aljazblatnik/RF-source-6GHz/gerber/README.md

# PCB stack (beta)

The attached gerber files are a BETA version of the PCBs, as they have not yet been fully verified. The table below dictates the bord stack for PCB:
| PCB | Material | thickness | 
| --- | --- | --- |
| RF board | FR4 | 2-layer 0.6 mm |
| MCU | FR4 | 2-layer 1.6 mm |
| Buttons | FR4 | 2-layser 1.6 mm |
