aljazblatnik/RF-source-6GHz/photo/+5V supply.JPEG

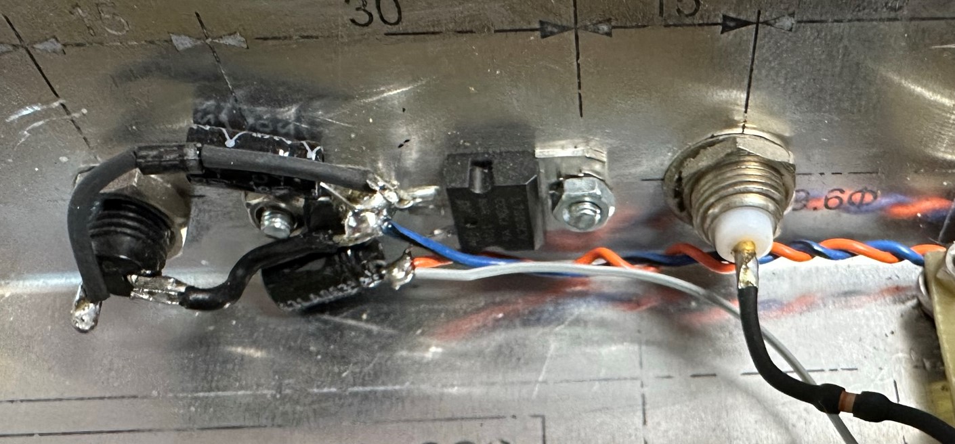
photo/+5V supply.JPEG
