aljazblatnik/RF-source-6GHz/photo/back.JPEG

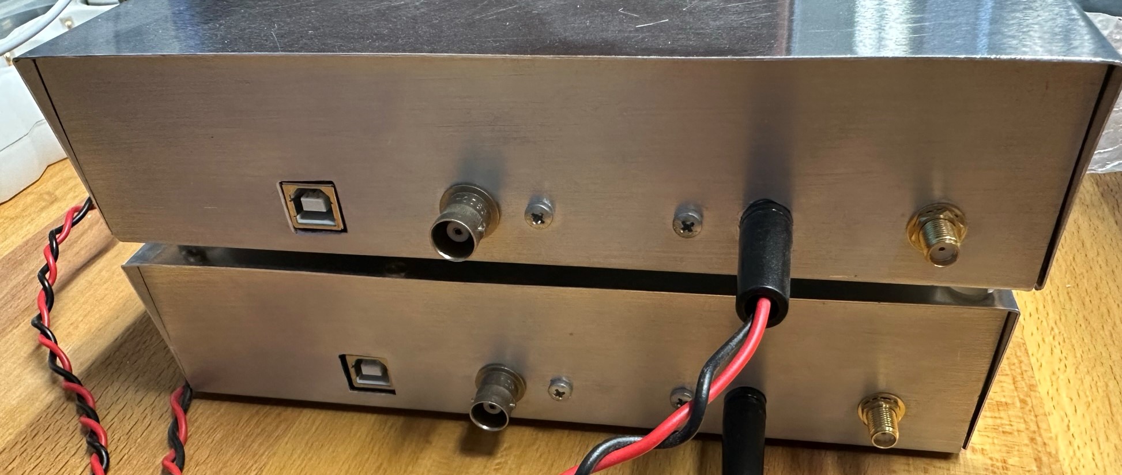
photo/back.JPEG
