aljazblatnik/RF-source-6GHz/photo/buttons.JPEG

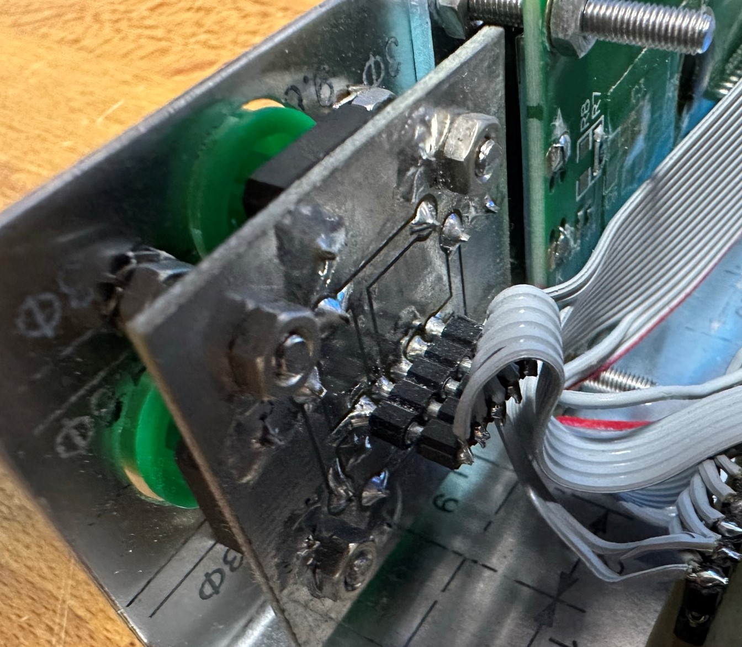
photo/buttons.JPEG
