aljazblatnik/RF-source-6GHz/photo/buttons_back.jpg

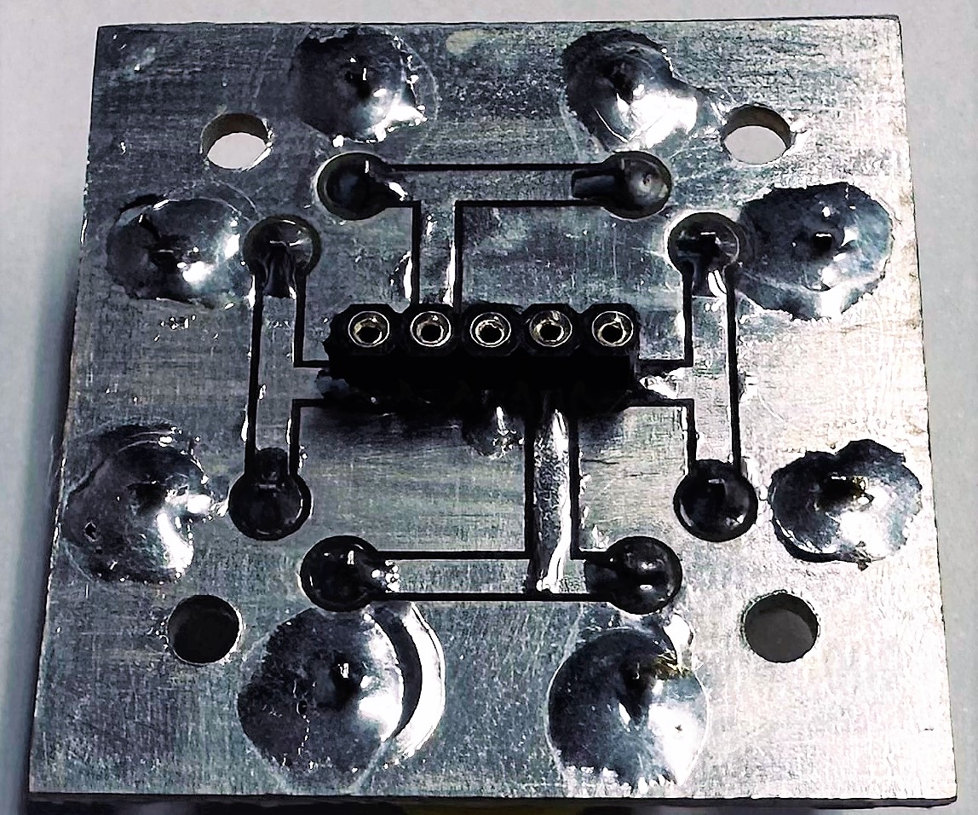
photo/buttons_back.jpg
