aljazblatnik/RF-source-6GHz/photo/buttons_front.jpg

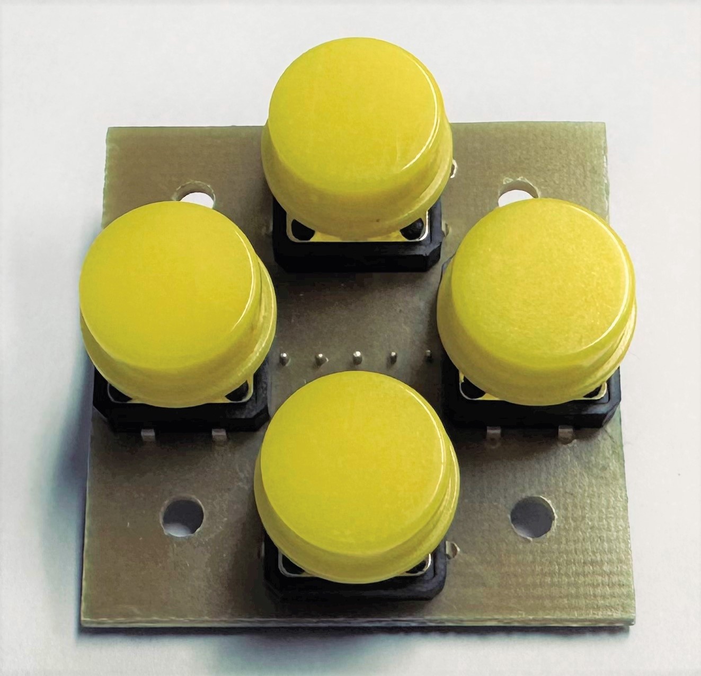
photo/buttons_front.jpg
