aljazblatnik/RF-source-6GHz/photo/connections.JPEG

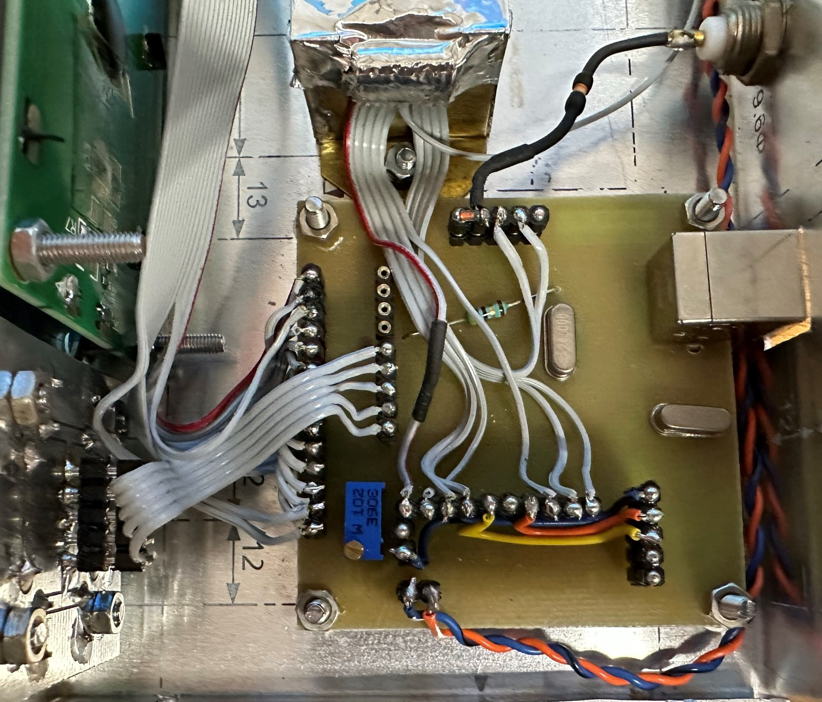
photo/connections.JPEG
