aljazblatnik/RF-source-6GHz/photo/MCU_bottom.jpg

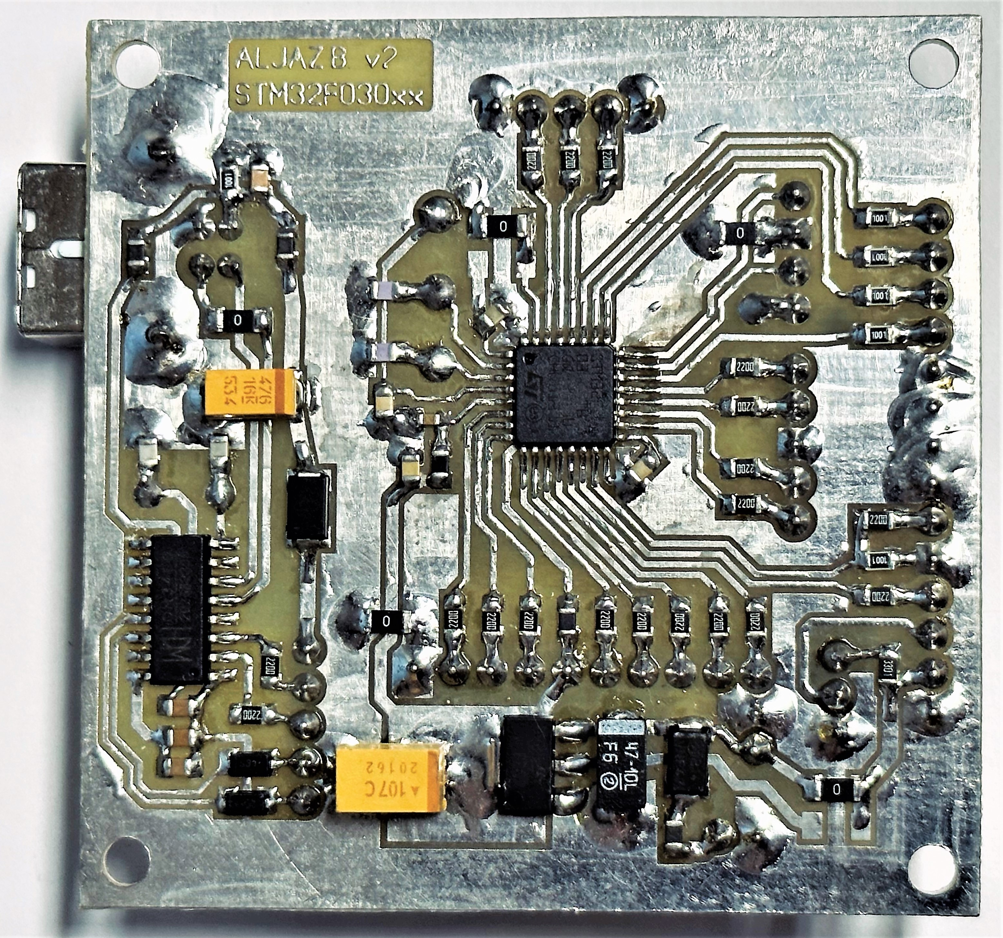
photo/MCU_bottom.jpg
