aljazblatnik/RF-source-6GHz/photo/MCU_top.jpg

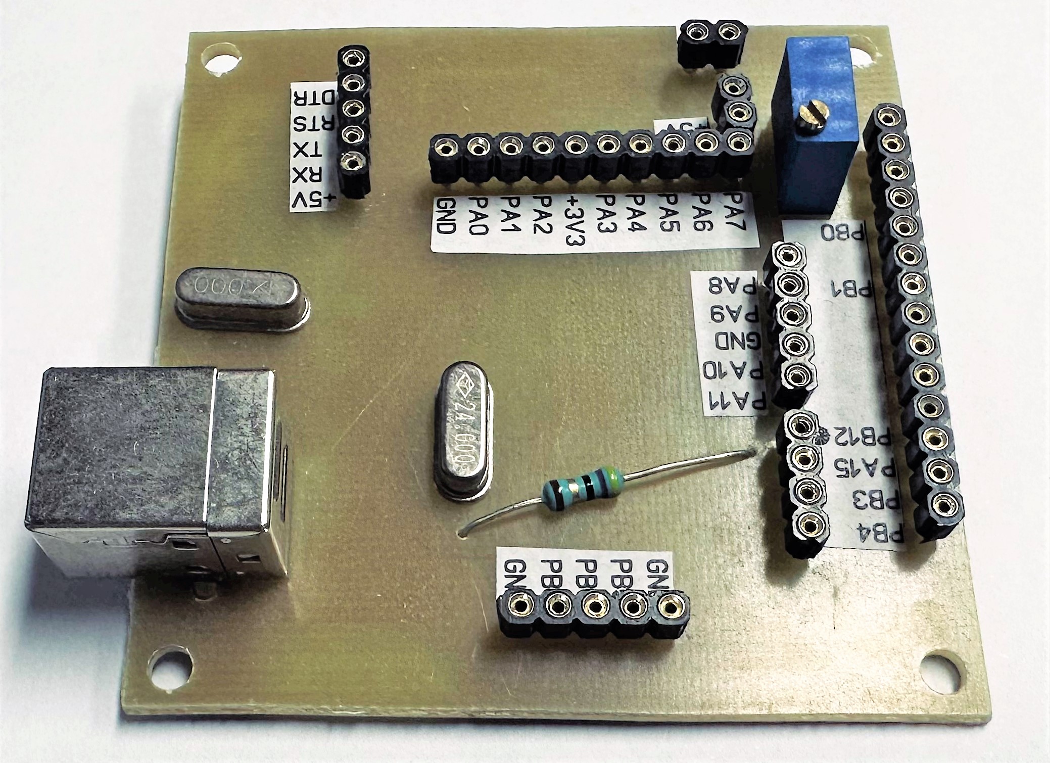
photo/MCU_top.jpg
