aljazblatnik/RF-source-6GHz/photo/modulation.JPEG

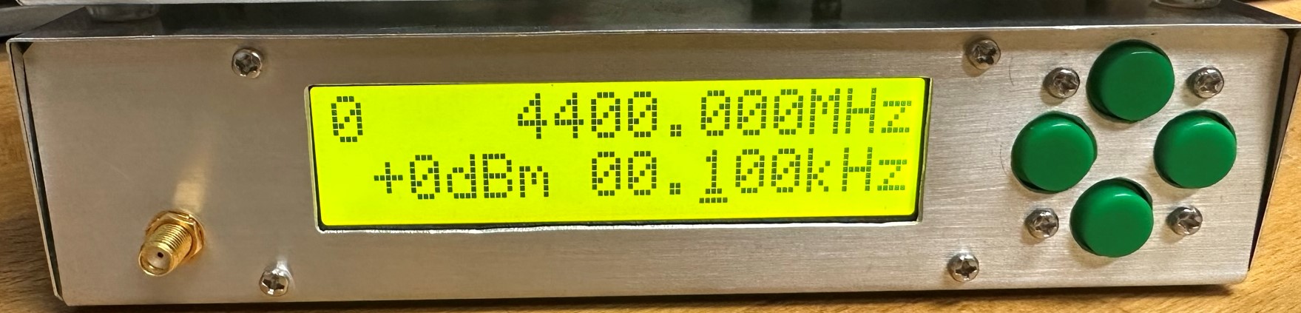
photo/modulation.JPEG
