aljazblatnik/RF-source-6GHz/photo/RF connection.JPEG

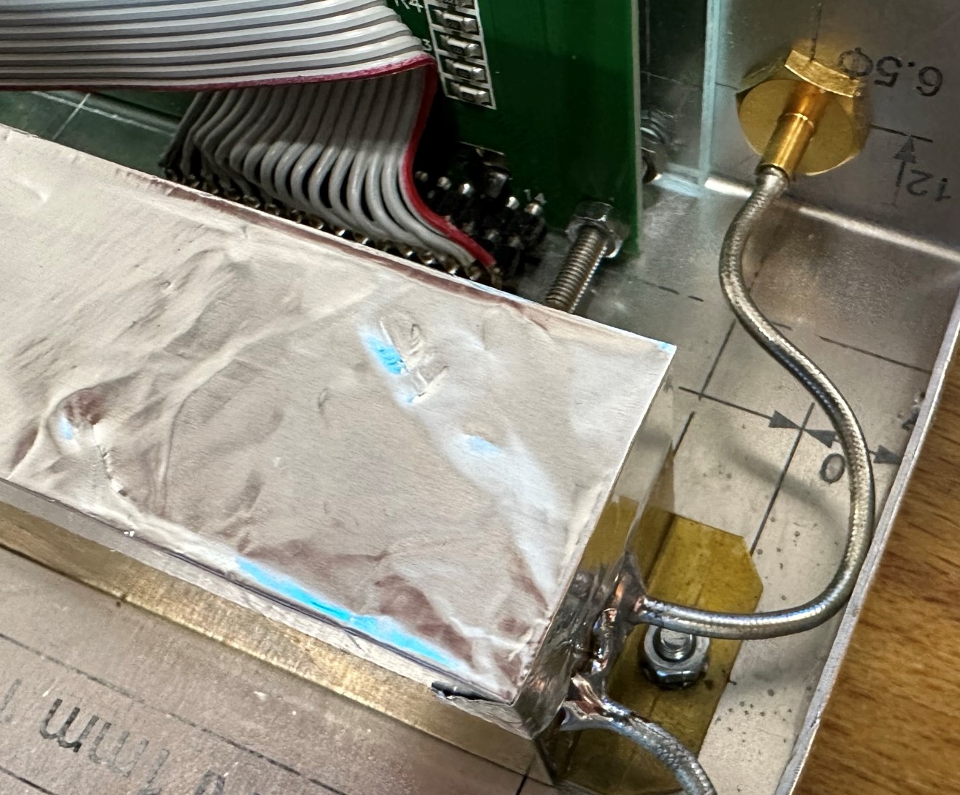
photo/RF connection.JPEG
