aljazblatnik/RF-source-6GHz/schematic_v2_shielding.png

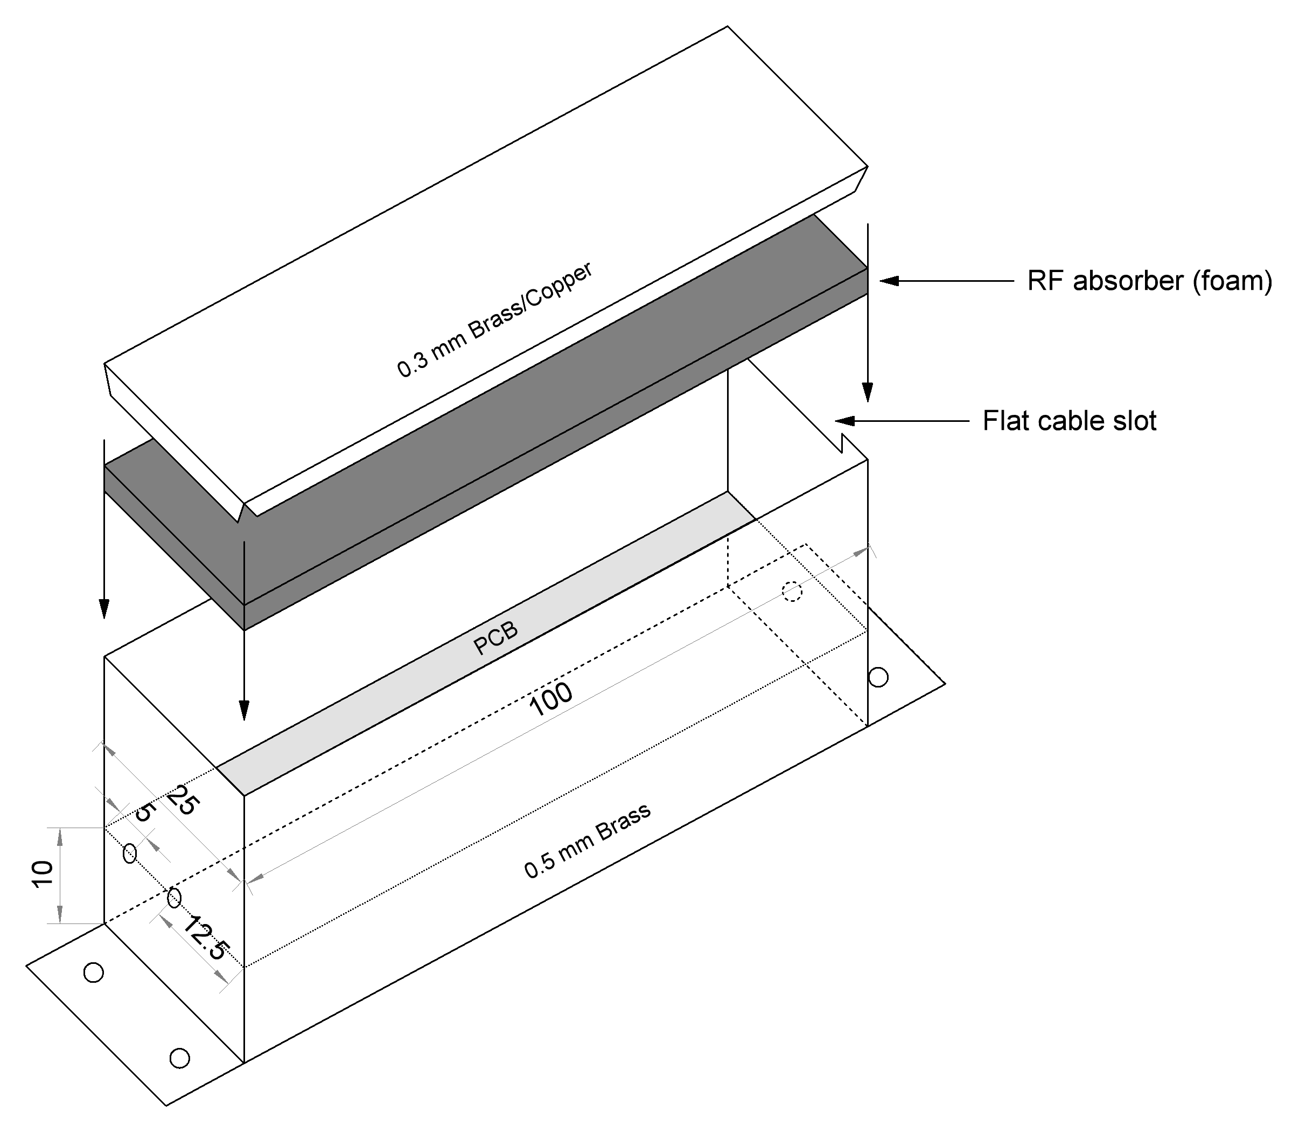
schematic_v2_shielding.png
