aljazblatnik/RF-source-6GHz/calibration/calibration_two_prototypes.txt

# kalibracija moder 2 MHz - 25 - 6499
{4,3},{5,3},{7,0},{8,0},{9,3},{9,3},{10,3},{11,1},{11,3},{12,1}, 
{12,3},{12,3},{13,2},{13,3},{14,0},{14,1},{14,2},{14,3},{14,3},{15,0}, 
{15,1},{15,2},{15,2},{15,2},{15,3},{15,3},{15,3},{15,3},{15,3},{16,0}, 
{16,0},{16,1},{16,1},{16,1},{16,1},{16,1},{16,1},{16,1},{16,1},{16,1}, 
{16,2},{16,1},{16,1},{16,1},{16,1},{16,2},{16,2},{16,2},{16,2},{16,2}, 
{16,2},{16,2},{16,2},{16,2},{16,2},{16,2},{16,2},{16,2},{16,2},{16,2}, 
{16,2},{16,2},{16,1},{16,1},{16,1},{16,1},{16,1},{16,1},{16,1},{16,1}, 
{16,1},{16,1},{16,1},{16,1},{16,1},{16,1},{16,1},{16,1},{16,1},{16,1}, 
{16,1},{16,1},{16,1},{16,1},{16,1},{16,1},{16,1},{16,1},{16,1},{16,1}, 
{16,1},{16,1},{16,1},{16,1},{16,1},{16,1},{16,1},{16,1},{16,1},{16,1}, 
{16,1},{16,1},{16,1},{16,1},{16,1},{16,1},{16,1},{16,1},{16,1},{16,1}, 
{16,2},{16,2},{16,1},{16,2},{16,1},{16,1},{16,1},{16,1},{16,1},{16,1}, 
{16,1},{16,1},{16,1},{16,1},{16,2},{16,1},{16,2},{16,2},{16,1},{16,1}, 
{16,1},{16,1},{16,1},{16,1},{16,1},{16,1},{16,1},{16,1},{16,1},{16,1}, 
{16,1},{16,1},{16,1},{16,1},{16,1},{16,2},{16,2},{16,2},{16,2},{16,2}, 
{16,2},{16,2},{16,2},{16,2},{16,2},{16,2},{16,2},{16,2},{16,2},{16,2}, 
{16,2},{16,2},{16,2},{16,2},{16,2},{16,2},{16,2},{16,2},{16,2},{16,2}, 
{16,2},{16,2},{16,2},{16,2},{16,2},{16,2},{16,1},{16,1},{16,1},{16,1}, 
{16,1},{16,1},{16,1},{16,1},{16,1},{16,1},{16,1},{16,1},{16,1},{16,1}, 
{16,1},{16,1},{16,1},{16,1},{16,1},{16,1},{16,1},{16,1},{16,1},{16,1}, 
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
{16,1},{16,1},{16,2},{16,2},{16,2},{16,2},{16,2},{16,2},{16,2},{16,2}, 
{16,2},{16,2},{16,2},{16,2},{16,2},{16,2},{16,3},{16,3},{16,3},{16,2}, 
{16,3},{16,3},{16,3},{16,2},{16,2},{16,2},{16,2},{16,2},{16,2},{16,2}, 
{16,2},{16,2},{16,2},{16,2},{16,1},{16,1},{16,1},{16,1},{16,1},{16,1}, 
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
