aljazblatnik/RF-source-6GHz/output_power measurement.xlsx

Sheet: 0dB atten
F | dBm
25000 | 4.42 | 25
50000 | 13.43 | 50
75000 | 15.67 | 75
100000 | 16.23 | 100
125000 | 16.31 | 125
150000 | 16.24 | 150
175000 | 16.2 | 175
200000 | 16.31 | 200
225000 | 16.18 | 225
250000 | 16.18 | 250
275000 | 16.21 | 275
300000 | 16.1 | 300
325000 | 16.32 | 325
350000 | 16.22 | 350
375000 | 16.29 | 375
400000 | 16.15 | 400
425000 | 15.97 | 425
450000 | 16.21 | 450
475000 | 16.12 | 475
500000 | 16.17 | 500
525000 | 16.16 | 525
550000 | 16.17 | 550
575000 | 16.22 | 575
600000 | 15.99 | 600
625000 | 16.11 | 625
650000 | 16.12 | 650
675000 | 16.03 | 675
700000 | 16.27 | 700
725000 | 16.04 | 725
750000 | 16.31 | 750
775000 | 16.37 | 775
800000 | 16.38 | 800
825000 | 16.33 | 825
850000 | 16.36 | 850
875000 | 16.47 | 875
900000 | 16.43 | 900
925000 | 16.45 | 925
950000 | 16.39 | 950
975000 | 16.46 | 975
1000000 | 16.62 | 1000
1025000 | 16.44 | 1025
1050000 | 16.43 | 1050
1075000 | 16.46 | 1075
1100000 | 16.46 | 1100
1125000 | 16.37 | 1125
1150000 | 16.49 | 1150
1175000 | 16.61 | 1175
1200000 | 16.53 | 1200
1225000 | 16.39 | 1225
1250000 | 16.38 | 1250
1275000 | 16.41 | 1275
1300000 | 16.43 | 1300
1325000 | 16.41 | 1325
1350000 | 16.5 | 1350
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
