aljazblatnik/RF-source-6GHz/Al_case.pdf

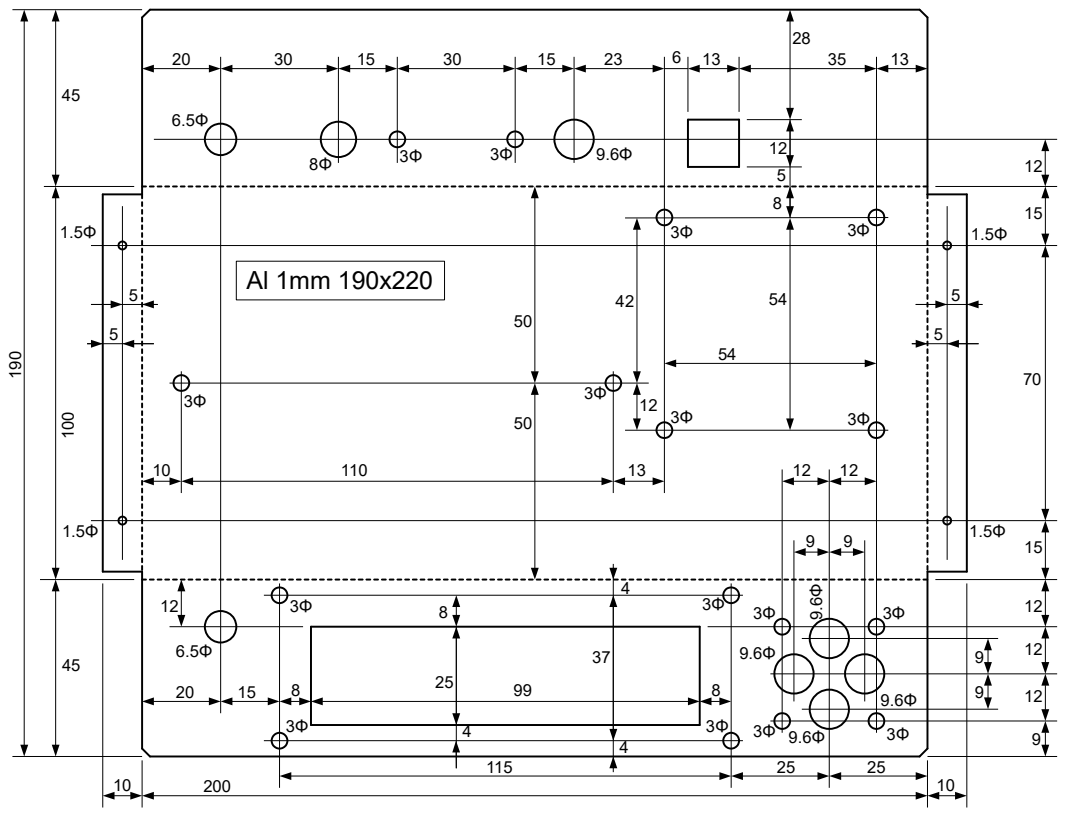
[picture p22: page 1]
