aljazblatnik/RF-source-6GHz/(list of files, drawings)

Other design files:
MAX2871_PLL_6GHz_PCB.lay6
MAX2871_PLL_6GHz_schematics.spl8
