aljazblatnik/RF-source-6GHz/EmBitz_RF_source_6GHz_STM32F030K6/src/usart.c

#include "stm32f0xx.h"
#include "system_stm32f0xx.h"
#include <stdio.h>
#include <stdlib.h>
#include <string.h>

#include "delay.h"
#include "usart.h"
#include "attenuator.h"
#include "menu.h"
#include "flash.h"
#include "calibration.h"

extern int buff_index;

extern int cursor;
extern int program;
extern char status;
extern int frequency; // kHz
extern int power; // dBm
extern int modulation; // Hz

void usart_init(void){
    RCC->APB2ENR |= (RCC_APB2ENR_USART1EN); // clock

    //USART1->BRR = 0x340; // 115.25 KBps
    USART1->BRR = 0x2710; // 9600 bits/s
    USART1->CR1 |= USART_CR1_OVER8;
    USART1->CR1 |= USART_CR1_RE; // receive enable
    USART1->CR1 |= USART_CR1_TE; // transmit enable
    USART1->RTOR = 0xFFFFFF; // timeout value
    USART1->CR1 |= USART_CR1_RXNEIE; // receive interrupt setup
    USART1->CR1 |= USART_CR1_UE; // usart enable

    NVIC_SetPriority(USART1_IRQn,9);   //enable interrupt
    NVIC_EnableIRQ(USART1_IRQn);

}

void usart_send_string(char *str){
    int i = 0;
    while(str[i] != '\0'){
        USART1->TDR = str[i] ;
        i++;
        while(!(USART1->ISR & USART_ISR_TC));
    }
}

void usart_send_byte(unsigned char byte){
    USART1->TDR = byte;
    while(!(USART1->ISR & USART_ISR_TC));
}

char* int_to_dec_string(int i, char b[]){
    char const digit[] = "0123456789";
    char* p = b;
    // negative number
    if(i<0){
        *p++ = '-';
        i *= -1;
    }
    int shifter = i;
    do{ //Move to where representation ends
        ++p;
        shifter = shifter/10;
    }while(shifter);
    *p = '\0';
    do{ //Move back, inserting digits as u go
        *--p = digit[i%10];
        i = i/10;
    }while(i);
    return b;
}

void usart_send_report(void){
    char str[9];
    int_to_dec_string(program,str);
    usart_send_string(str);
    usart_send_byte(' ');
    usart_send_byte(status);
    usart_send_byte(' ');
    int_to_dec_string(frequency,str);
    usart_send_string(str);
    usart_send_string("kHz ");
    int_to_dec_string(power,str);
    usart_send_string(str);
    usart_send_string("dBm ");
    int_to_dec_string(modulation,str);
    usart_send_string(str);
    usart_send_string("Hz\r\n");
}

int string_to_int(char *str, int length){
    // length including sign character!
    unsigned int result = 0;
    char const digit[] = "0123456789";
    int i = 0;
    int sign = 1;
    if(str[0] == '-'){
        sign = -1;
        length--;
        i = 1;
    }
    else if(str[0] == '+'){
        sign = 1;
        length--;
        i = 1;
    }
    while(length){
        int n;
        for(n=0; digit[n]; n++){
            if(digit[n] == str[i]){
                break;
            }
        }
        if (n > 9) n = 0; // not a digit but other ASCII char.
        result *= 10;
        result += n;
        i++;
        length--;
    }
    result *= sign;
    return result;
}

int compare_string(char *first, char *second){ // sub-string
    while (*first == *second) {
        if (*first == '\0' || *second == '\0')
            break;
        first++;
        second++;
    }

    if (*second == '\0')
        return 0;
    else
        return -1;
}

int command_decode(char *str){
    if(buff_index == 0){
        //usart_send_report();
        return 0;
    }
    if(compare_string(str, "help") == 0){
        usart_send_string("\r\nA xxx - amplitude [+/-dBm]\r\nF xxxxxxx - frequency [kHz]\r\nM xxxxx - modulation [Hz]\r\nP 123456789 - save settings\r\nR - reset, S x - memory\r\n\r\n");
    }
    else if(compare_string(str, "A ") == 0){
        int result = string_to_int(&str[2],3);
        power = calibrationReturnPower(frequency, result); // check for a Max and Min setting (to correct on display)
        usart_send_string("OK\r\n");
    }
    else if(compare_string(str, "F ") == 0){
        int result = string_to_int(&str[2],7);
        frequency = result;
        if(frequency > 7000000) frequency = 6000000; // upper limit
        if(frequency < 0) frequency = 0; // lower limit
        usart_send_string("OK\r\n");
    }
    else if(compare_string(str, "M ") == 0){
        int result = string_to_int(&str[2],5);
        modulation = result;
        if(modulation > 50000) modulation = 50000; // upper limit
        if(modulation < 0) modulation = 0; // lower limit
        usart_send_string("OK\r\n");
    }
    else if(compare_string(str, "P 123456789") == 0){
        flashWriteChanges();
        usart_send_string("OK\r\n");
    }
    else if(compare_string(str, "R") == 0){
        usart_send_string("OK\r\n");
        NVIC_SystemReset();
    }
    else if(compare_string(str, "S ") == 0){
        int result = string_to_int(&str[2],1);
        program = result;
        menuLoadDataFromMemoryToWorkingRAM(program);
        usart_send_string("OK\r\n");
    }
    else if(compare_string(str, "Att ") == 0){
        int result = string_to_int(&str[4],3);
        attenuator_send(result);
        usart_send_string("OK\r\n");
        return 0; // do not update menu
    }
    else{
        usart_send_string("Unrecognized command. Try help.\r\n");
        buff_index = 0;
        return 0;
    }
    buff_index = 0;
    return 1;
}
