aljazblatnik/RF-source-6GHz/EmBitz_RF_source_6GHz_STM32F030K6/inc/menu.h

#ifndef MENU_H_INCLUDED
#define MENU_H_INCLUDED

void menuLoadDataFromMemoryToWorkingRAM(int program);
void menuSaveDataFromWorkingRAMToMemory(int program);
void moveCursorLR();
void moveCursorUD();
void menuShow();
void menuShowSpecial();
void menuShowStatus(char status);
void menuShowFrequency(int new_frequency);

#endif /* MENU_H_INCLUDED */
