aljazblatnik/RF-source-6GHz/EmBitz_RF_source_6GHz_STM32F030K6/inc/attenuator.h

#ifndef ATTENUATOR_H_INCLUDED
#define ATTENUATOR_H_INCLUDED

void attenuator_init(void);
void attenuator_send(unsigned char data); // raw data
void attenuator_set_attenuation(float attenuation); // 0 - 31.75 dB

#endif /* ATTENUATOR_H_INCLUDED */
