aljazblatnik/RF-source-6GHz/EmBitz_RF_source_6GHz_STM32F030K6/inc/texts.h

#ifndef TEXTS_H_INCLUDED
#define TEXTS_H_INCLUDED

#define HELP "This is a help document. All commands are listed here.\r\n\r\n    help         help command\r\n    send         sends all data to MAX2871 chip\r\n    send -auto   sets data to be sent to MAX2871 automatically\r\n    send -man    sets data to be sent to MAX2871 manually\r\n    send ?       displays current mode of send command\r\n    enable rf    enable RF output\r\n    disable rf   disable RF output\r\n    enable chip  enable chip\r\n    disable chip disable chip\r\n\r\n    R<number> <value>   sets register R<number: 0-5> a HEX <value>\r\n    R<number> ?         displays register R<number: 0-5> value\r\n    R -all              displays all registers values\r\n"

#endif /* TEXTS_H_INCLUDED */
