aljazblatnik/RF-source-6GHz/EmBitz_RF_source_6GHz_STM32F030K6/src/calibration.c

#include "stm32f0xx.h"
#include "system_stm32f0xx.h"

#include "delay.h"

// calibration step
const int step = 2000;

// array - number * 2 MHz
// 1. char - max power in dBm (as written on a screen)
// 2. char - attenuator setting to achieve this power (value in byte - attn. setting)

const char calibrationMax[3238][2] = {
{4,3},{5,3},{7,0},{8,0},{9,3},{9,3},{10,3},{11,1},{11,3},{12,1},
{12,3},{12,3},{13,2},{13,3},{14,0},{14,1},{14,2},{14,3},{14,3},{15,0},
{15,1},{15,2},{15,2},{15,2},{15,3},{15,3},{15,3},{15,3},{15,3},{16,0},
{16,0},{16,1},{16,1},{16,1},{16,1},{16,1},{16,1},{16,1},{16,1},{16,1},
{16,2},{16,1},{16,1},{16,1},{16,1},{16,2},{16,2},{16,2},{16,2},{16,2},
{16,2},{16,2},{16,2},{16,2},{16,2},{16,2},{16,2},{16,2},{16,2},{16,2},
{16,2},{16,2},{16,1},{16,1},{16,1},{16,1},{16,1},{16,1},{16,1},{16,1},
{16,1},{16,1},{16,1},{16,1},{16,1},{16,1},{16,1},{16,1},{16,1},{16,1},
{16,1},{16,1},{16,1},{16,1},{16,1},{16,1},{16,1},{16,1},{16,1},{16,1},
{16,1},{16,1},{16,1},{16,1},{16,1},{16,1},{16,1},{16,1},{16,1},{16,1},
{16,1},{16,1},{16,1},{16,1},{16,1},{16,1},{16,1},{16,1},{16,1},{16,1},
{16,2},{16,2},{16,1},{16,2},{16,1},{16,1},{16,1},{16,1},{16,1},{16,1},
{16,1},{16,1},{16,1},{16,1},{16,2},{16,1},{16,2},{16,2},{16,1},{16,1},
{16,1},{16,1},{16,1},{16,1},{16,1},{16,1},{16,1},{16,1},{16,1},{16,1},
{16,1},{16,1},{16,1},{16,1},{16,1},{16,2},{16,2},{16,2},{16,2},{16,2},
{16,2},{16,2},{16,2},{16,2},{16,2},{16,2},{16,2},{16,2},{16,2},{16,2},
{16,2},{16,2},{16,2},{16,2},{16,2},{16,2},{16,2},{16,2},{16,2},{16,2},
{16,2},{16,2},{16,2},{16,2},{16,2},{16,2},{16,1},{16,1},{16,1},{16,1},
{16,1},{16,1},{16,1},{16,1},{16,1},{16,1},{16,1},{16,1},{16,1},{16,1},
{16,1},{16,1},{16,1},{16,1},{16,1},{16,1},{16,1},{16,1},{16,1},{16,1},
{16,1},{16,1},{16,1},{16,1},{16,1},{16,1},{16,1},{16,1},{16,2},{16,1},
{16,2},{16,1},{16,1},{16,2},{16,2},{16,2},{16,2},{16,2},{16,2},{16,2},
{16,2},{16,2},{16,2},{16,2},{16,2},{16,2},{16,2},{16,2},{16,2},{16,2},
{16,2},{16,1},{16,1},{16,1},{16,1},{16,1},{16,1},{16,1},{16,1},{16,1},
{16,1},{16,1},{16,1},{16,1},{16,1},{16,1},{16,1},{16,1},{16,1},{16,1},
{16,1},{16,1},{16,1},{16,1},{16,1},{16,1},{16,1},{16,1},{16,1},{16,1},
{16,1},{16,1},{16,1},{16,1},{16,1},{16,1},{16,1},{16,1},{16,1},{16,1},
{16,1},{16,1},{16,1},{16,1},{16,1},{16,1},{16,1},{16,1},{16,1},{16,1},
{16,1},{16,1},{16,1},{16,1},{16,1},{16,1},{16,1},{16,1},{16,1},{16,1},
{16,1},{16,1},{16,1},{16,1},{16,1},{16,1},{16,0},{16,0},{16,0},{16,0},
{16,0},{16,0},{16,0},{16,0},{16,0},{16,0},{16,0},{16,0},{16,0},{16,1},
{16,1},{16,1},{16,1},{16,1},{16,1},{16,1},{16,1},{16,1},{16,1},{16,1},
{16,1},{16,1},{16,1},{16,1},{16,1},{16,1},{16,1},{16,1},{16,1},{16,1},
{16,1},{16,1},{16,2},{16,2},{16,2},{16,2},{16,2},{16,2},{16,2},{16,2},
{16,2},{16,2},{16,1},{16,1},{16,1},{16,1},{16,1},{16,1},{16,1},{16,1},
{16,1},{16,1},{16,1},{16,1},{16,1},{16,1},{16,1},{16,1},{16,1},{16,1},
{16,2},{16,2},{16,2},{16,2},{16,2},{16,2},{16,2},{16,2},{16,2},{16,3},
{16,3},{16,3},{16,3},{16,3},{16,3},{16,3},{16,3},{16,3},{16,3},{16,3},
{16,3},{16,3},{16,3},{16,3},{16,3},{16,3},{16,3},{16,3},{16,3},{16,2},
{16,2},{16,2},{16,2},{16,2},{16,2},{16,2},{16,2},{16,2},{16,2},{16,2},
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
};

char calibrationReturnMaxPower(int frequency){
    // return maximum power of that frequency
    int i = frequency/step;
    int j = frequency%step;
    if(j>(step/2)) i++; // round up if needed

    if(i>6475) i = 6475;
    if(i<0) i = 0;

    return calibrationMax[i][0];
}

char calibrationReturnMaxAttenuator(int frequency){
    // return attenuator setting of that frequency
    int i = frequency/step;
    int j = frequency%step;
    if(j>(step/2)) i++; // round up if needed

    if(i>6475) i = 6475;
    if(i<0) i = 0;

    return calibrationMax[i][1];
}

int calibrationReturnPower(int frequency, int power){
    // Return power based on frequency (max, min values)
    int maxPower = calibrationReturnMaxPower(frequency);

    if(power > maxPower){
        return maxPower;
    }
    else if(power < (maxPower-30)){
        return (maxPower - 30);
    }
    else{
        return power;
    }
}

char calibrationReturnAttenuation(int frequency, int power){
    // return attenuator setting based on a frequency and power
    char calPower = calibrationReturnMaxPower(frequency);
    char calAttenuator = calibrationReturnMaxAttenuator(frequency);

    if(power >= calPower){
        return calAttenuator;
    }
    else{
        char attenuatorSetting = calPower - power;
        attenuatorSetting = attenuatorSetting<<2; // left shift by 2
        char returnValue = attenuatorSetting + calAttenuator;
        if(returnValue > 0b01111111){
            return 0b01111111;
        }
        else{
            return returnValue;
        }
    }
}
