aljazblatnik/RF-source-6GHz/EmBitz_RF_source_6GHz_STM32F030K6/inc/calibration.h

#ifndef CALIBRATION_H_INCLUDED
#define CALIBRATION_H_INCLUDED

int calibrationReturnPower(int frequency, int power);
char calibrationReturnAttenuation(int frequency, int power);

#endif /* CALIBRATION_H_INCLUDED */
