aljazblatnik/RF-source-6GHz/(commit log)

2023-06-06 First public release
    [MAX2871_PLL_6GHz.lay6, MAX2871_PLL_6GHz.spl8, output_power measurement.xlsx]
2023-06-06 Added schematics .png format
2023-06-06 PCB files renamed
    [MAX2871_PLL_6GHz_PCB.lay6, MAX2871_PLL_6GHz_schematics.spl8]
2023-06-06 Removed old files
    [MAX2871_PLL_6GHz.lay6, MAX2871_PLL_6GHz.spl8]
2023-06-06 Schematic resolution
    Better resolution of schematic files
    [MAX2871_PLL_6GHz_schematics.spl8]
2023-06-11 LinkTime opt. Release
    Disabled Link Time optimization in Release mode (causing time critical ISR to stall)
    [main.c, modulation.c, usart.c]
2023-06-11 README update
    almost there
    [MAX2871_PLL_6GHz_schematics.spl8]
2023-06-11 RF shielding info added
    [MAX2871_PLL_6GHz_schematics.spl8]
2024-03-25 v2.2 (MOD error)
    MOD output not working in the default state - corrected
    [calibration.c, main.c, modulation.c]
2024-11-23 industrialPCBs
    Beta version of industrial PCBs added
    [MAX2871_PLL_6GHz_PCB.lay6]
